Pyroww/rds-async-alarm/media/Transmissor.jpg

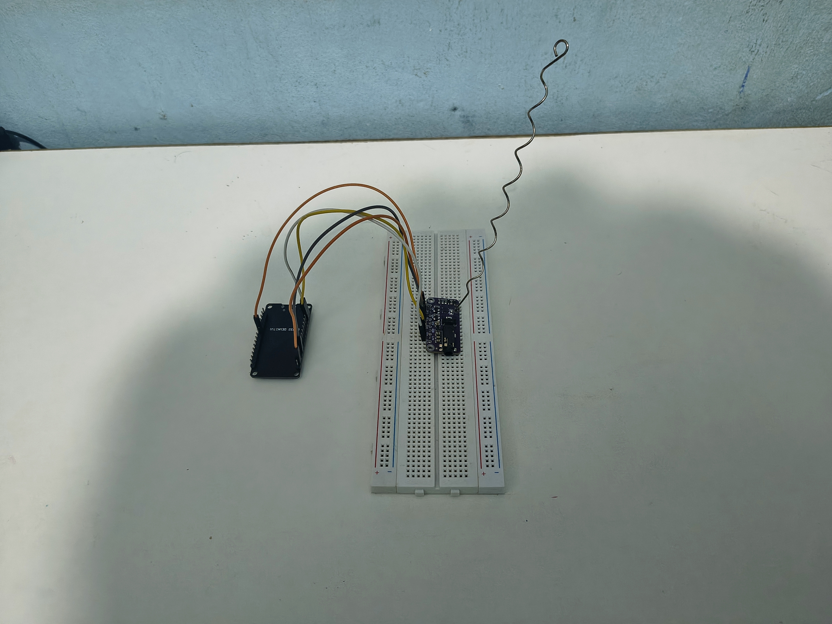
media/Transmissor.jpg
