Pyroww/rds-async-alarm/media/Receptor.jpg

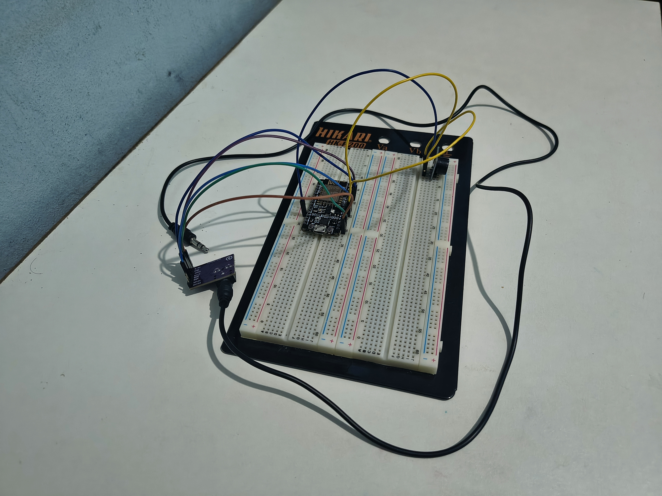
media/Receptor.jpg
