Pyroww/rds-async-alarm/docs/diagrama/Diagrama_sequencia.png

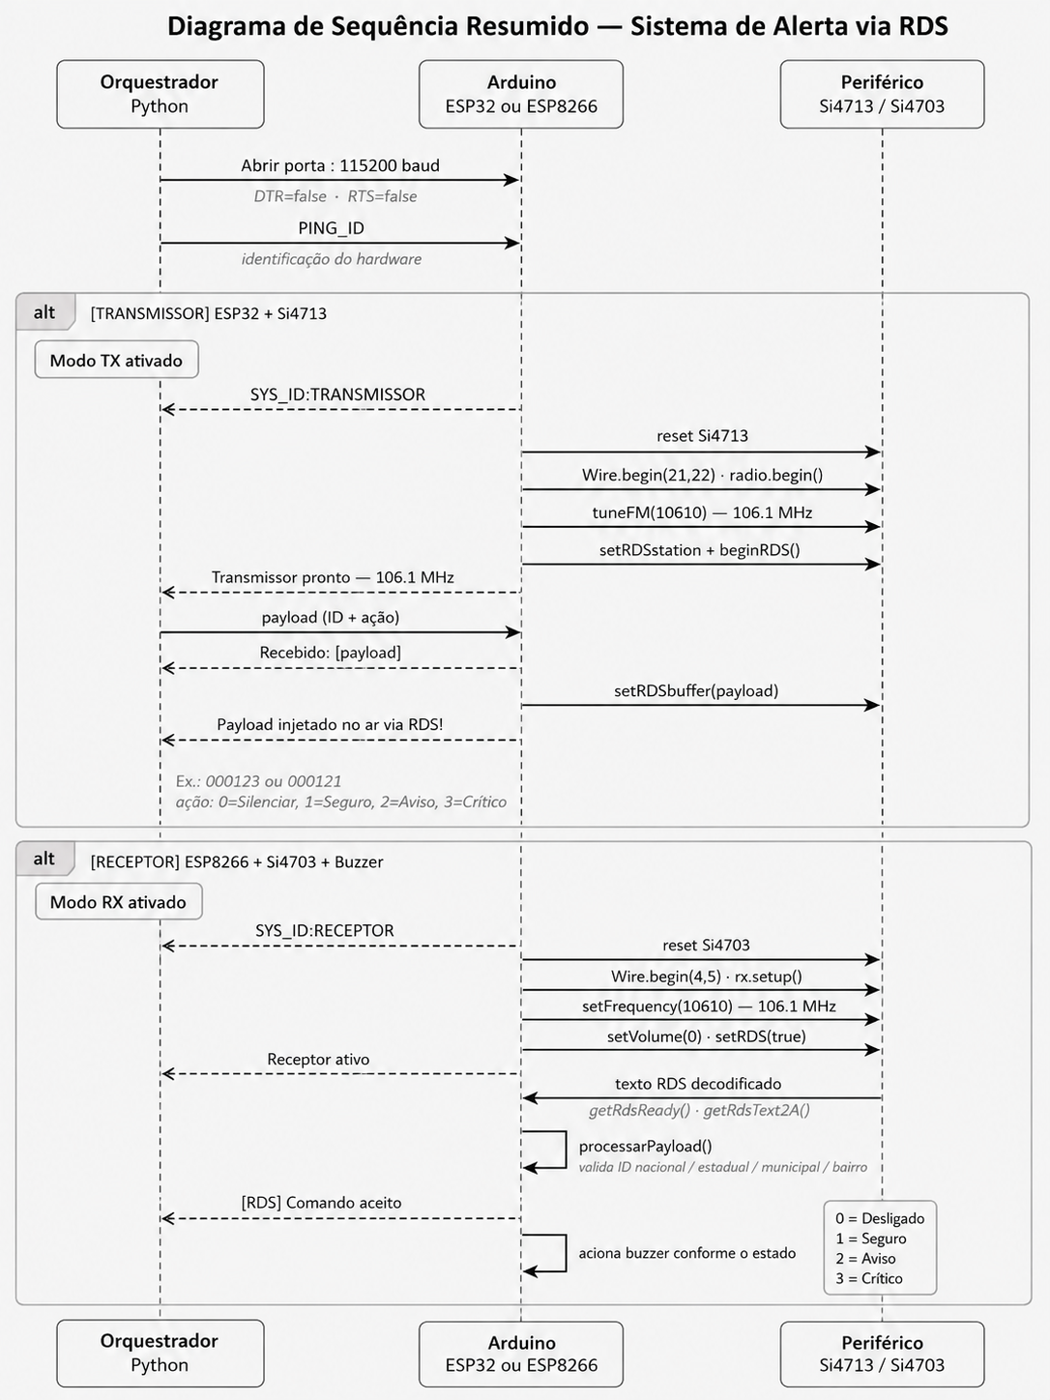
docs/diagrama/Diagrama_sequencia.png
