Pyroww/rds-async-alarm/docs/esquematicos/Diagrama_RXsi4703_esp8266.png

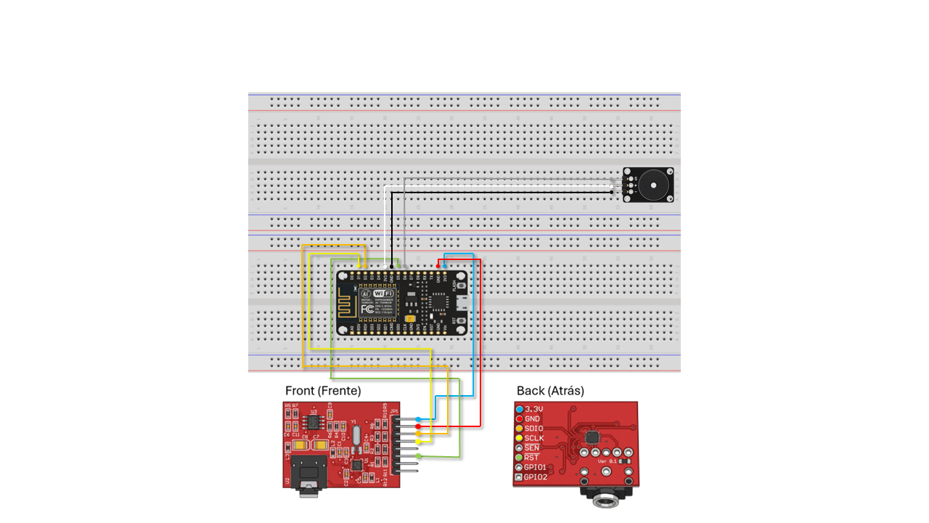
docs/esquematicos/Diagrama_RXsi4703_esp8266.png
