Pyroww/rds-async-alarm/docs/esquematicos/Diagrama_TXsi4713_esp32.png

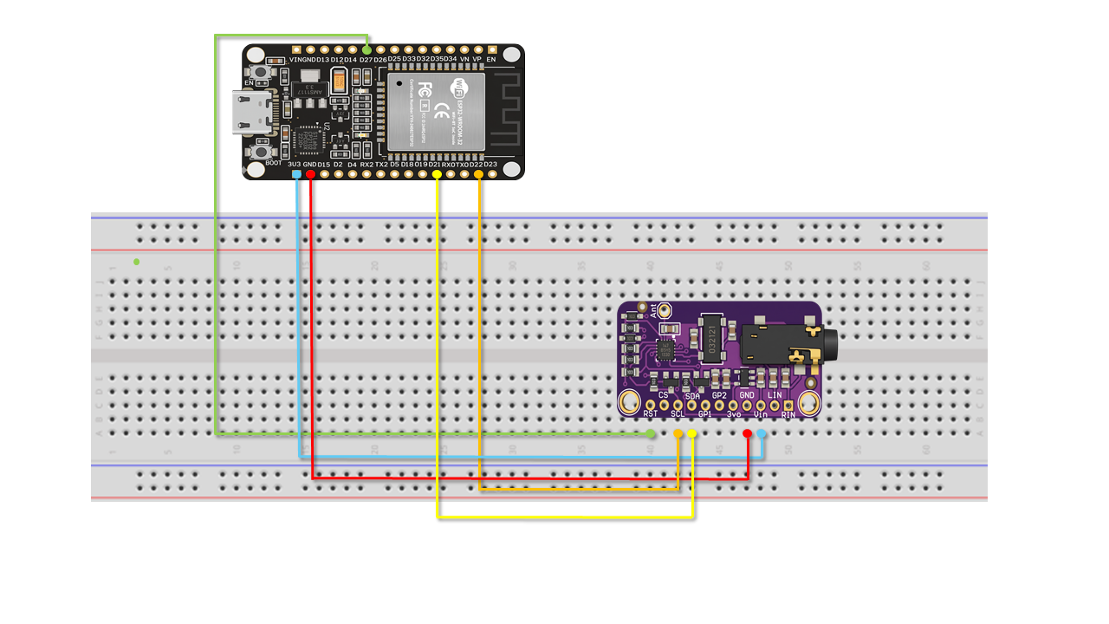
docs/esquematicos/Diagrama_TXsi4713_esp32.png
